JorjBauer/pic-wake-light/(commit log)

2006-12-31 now has clock capability, but no alarm. The mode button works but not set.
2007-01-01 working version, expecting a 2MHz crystal oscillator. Future versions should work on slower, but that's the slowest I had available...
    [delay.asm, main.asm]
2007-01-01 oops! forgot the lookup tables for the 7-segment LED.
2007-01-02 bugfix for 10 to 20 hour rollover (wasn't clearing ones digit)
    [main.asm]
2007-01-03 many more updates: cancel alarm, mode-button timeout, documentation...
2007-01-27 moved around some pins. bugfixes.
    [delay.asm, main.asm]
2007-01-28 bugfix: wasn't changing back to page 0 variables!
    [piceeprom.asm]
2007-01-29 bugfix: alarm wasn't working
    [main.asm]
2010-11-18 simple script to generate the proper fuse flags at install time
2010-11-18 imported schematic; currently v1.3
    [mainbrd.brd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]
2010-11-18 updated with current mouser parts
2010-12-25 reworking software to work at multiple clock rates. Memory statically allocated, and using generic 16f628a linker (rather than hacking the linker script). Delays rewritten generically based on clock 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
    [delay.asm, main.asm, memory.asm, piceeprom.asm]
2010-12-25 moved to internal oscillator while testing
    [main.asm]
2010-12-25 lookup table corrected for current 7-segment
    [lookup-tables.asm]
2010-12-28 moved to 32kHz watch crystal. Very accurate, much lower power consumption. Added a blink between mode button presses so there's a visual indication that the press happened.
2010-12-29 added assembly text with part numbers from Mouser...
2010-12-29 improved assembly docs.
2010-12-29 updated schematic and board: added 32kHz oscillator and caps; moved LED connector; fixed inductor through-holes
    [mainbrd.brd, mainbrd.sch]
2010-12-29 updated schematic; generated new gerber files for v1.4.
    [mainbrd.brd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]
